HeyPCB/iris-brow/media/top.png

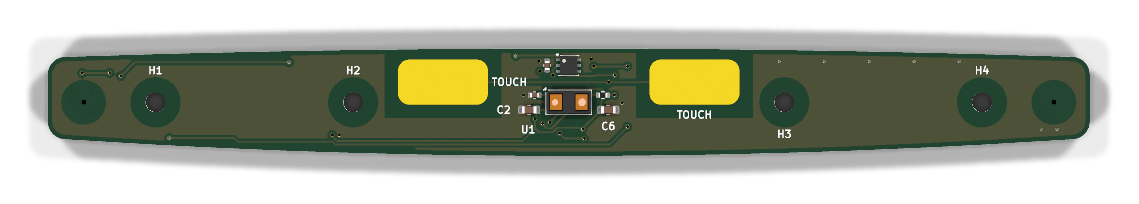
media/top.png
