HeyPCB/iris-brow/fab/iris_brow_bom.csv

Reference | Value | Footprint | MPN | LCSC | Qty
C1,C4,C5 | 100nF | Capacitor_SMD:C_0402_1005Metric | CL05B104KO5NNNC | C1525 | 3
C2 | 4.7uF | Capacitor_SMD:C_0603_1608Metric | CL10A475KO8NNNC | C19666 | 1
C3 | 1uF | Capacitor_SMD:C_0402_1005Metric | CL05A105KA5NQNC | C52923 | 1
C6 | 10uF | Capacitor_SMD:C_0603_1608Metric | CL10A106MA8NRNC | C96446 | 1
J1 | BROW (Cortex J4) | Connector_JST:JST_SH_SM08B-SRSS-TB_1x08-1MP_P1.00mm_Horizontal | SM08B-SRSS-TB(LF)(SN) | C160407 | 1
MK1,MK2 | ICS-43434 | Sensor_Audio:InvenSense_ICS-43434-6_3.5x2.65mm | ICS-43434 | C5656610 | 2
R1 | 10k | Resistor_SMD:R_0402_1005Metric | 0402WGF1002TCE | C25744 | 1
R2,R3 | 33 | Resistor_SMD:R_0402_1005Metric | 0402WGF330JTCE | C25105 | 2
U1 | VL53L1X | Sensor_Distance:ST_VL53L1x | VL53L1CXV0FY/1 | C190004 | 1
U2 | APDS-9306-065 | OptoDevice:Broadcom_DFN-6_2x2mm_P0.65mm | APDS-9306-065 | C2649498 | 1
