HeyPCB/iris-brow/fab/iris_brow.step

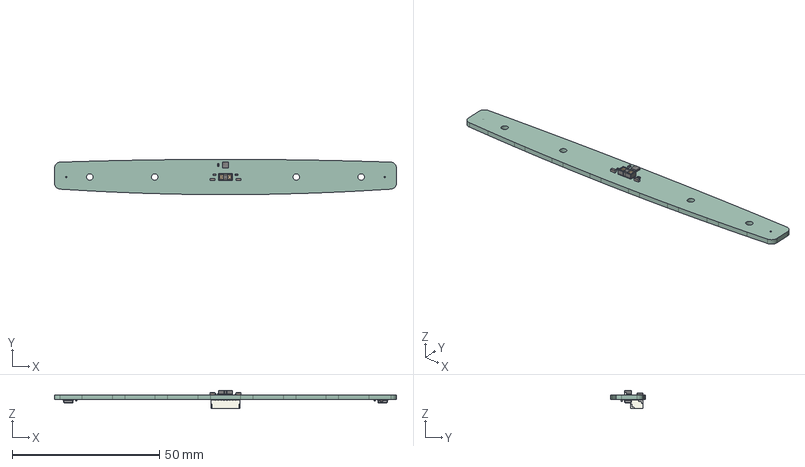
[picture p7: CAD file, 2026-10-03]
fab/iris_brow.step
116.0 x 12.0 x 6.20 mm
C_0402_1005Metric x 4
C_0603_1608Metric x 2
ST_VL53L1x
R_0402_1005Metric x 3
DFN-6-1EP_2x2mm_Pitch0.65mm
InvenSense_ICS-43434-6_3.5x2.65mm x 2
JST_SH_SM08B-SRSS-TB_1x08-1MP_P1.00mm_Horizontal
iris_brow_PCB
