HeyPCB/iris-brow/fab/iris_brow_schematic.pdf

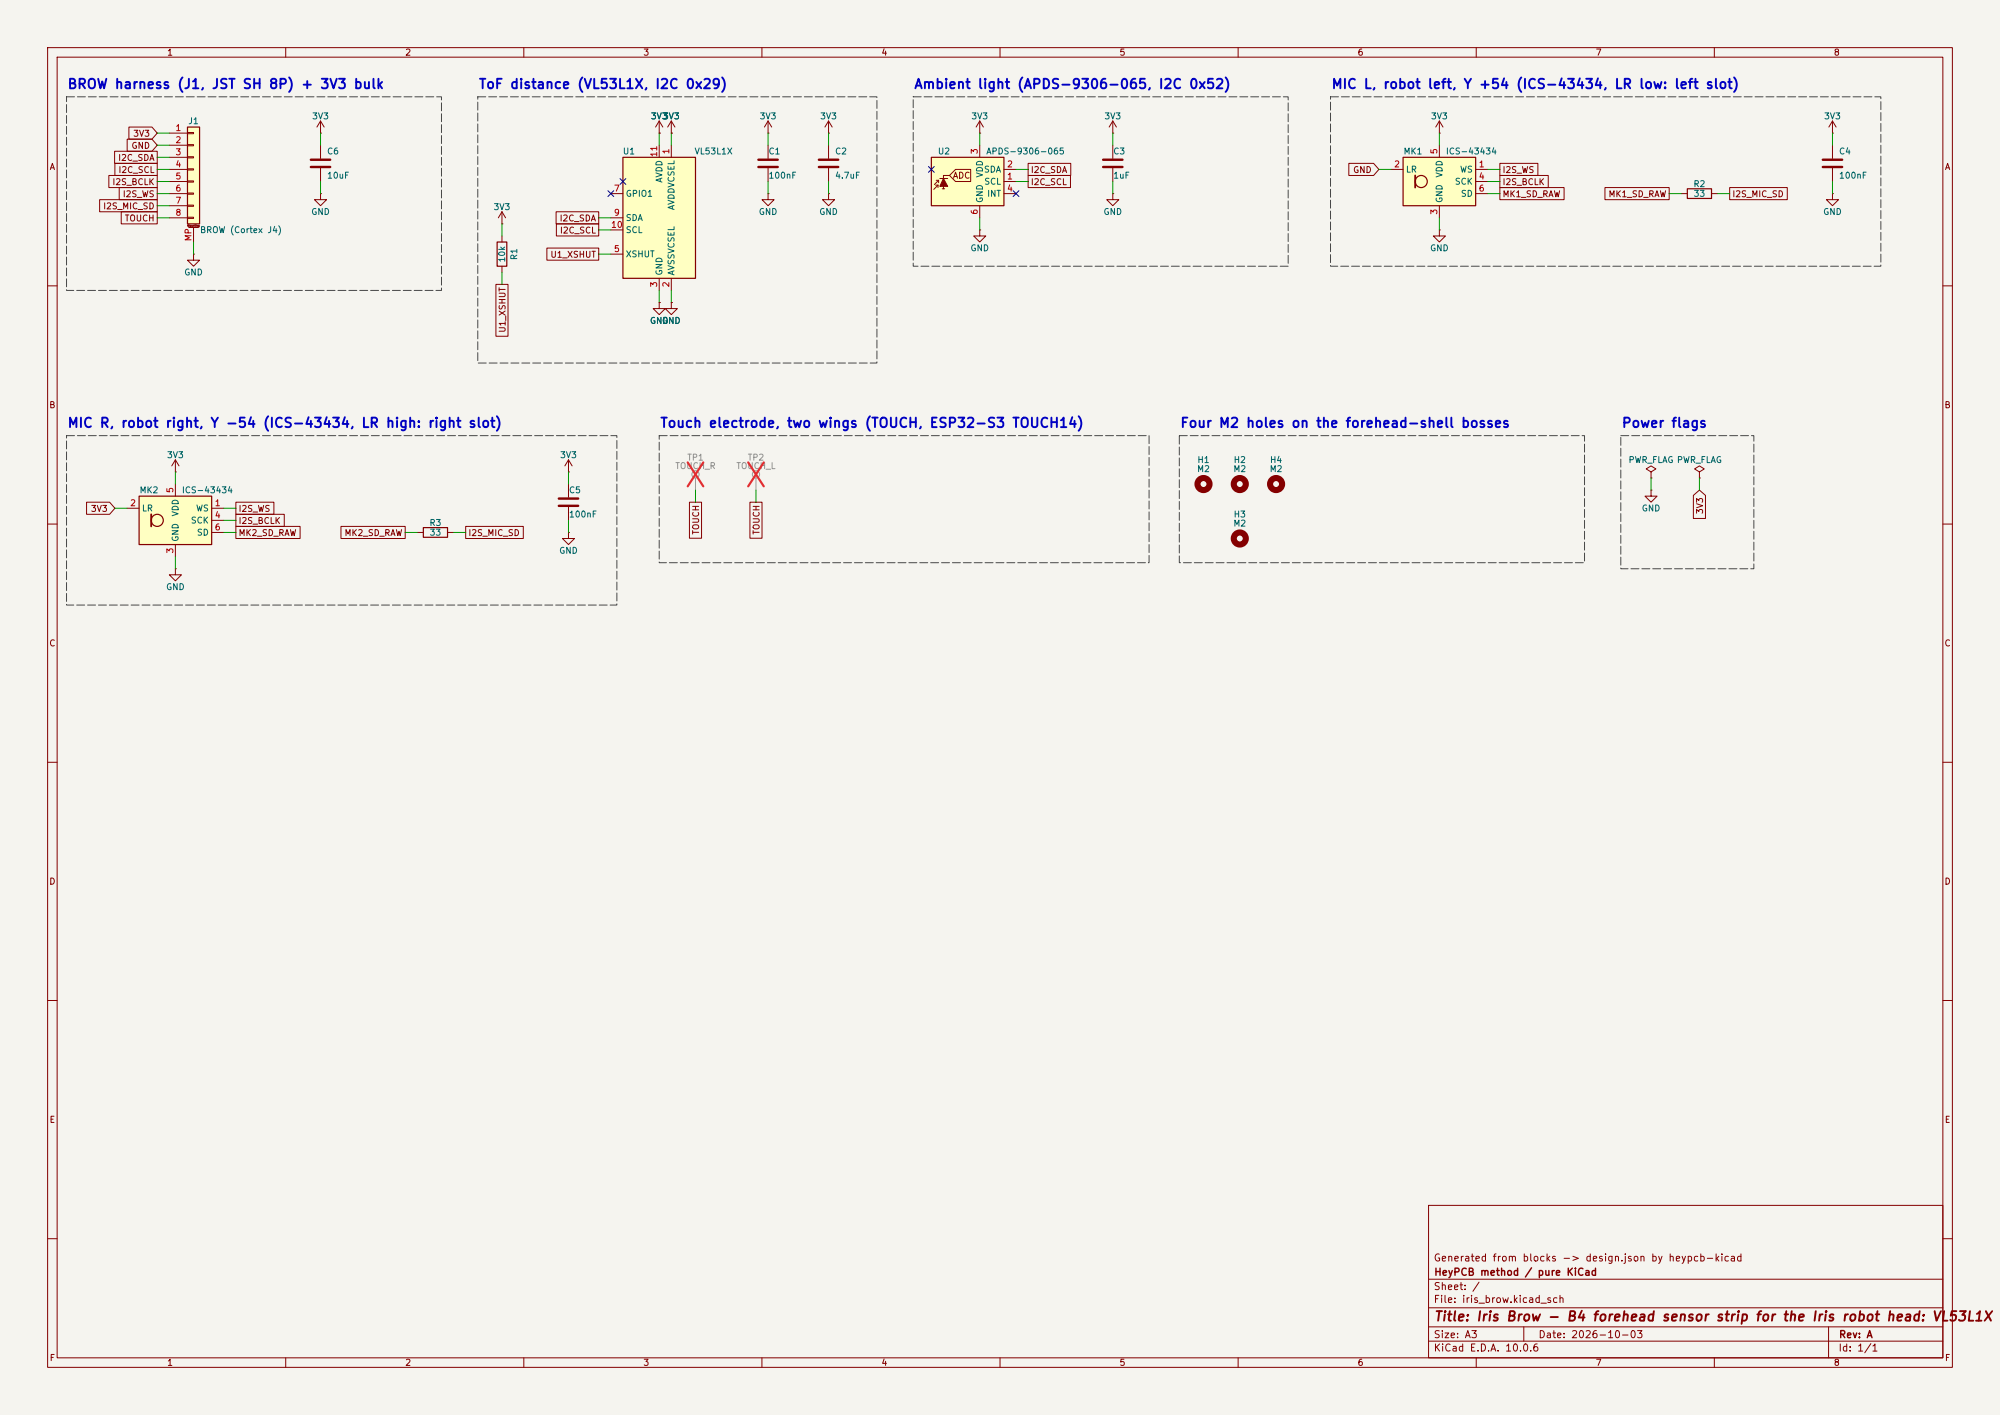
[picture p8: page 1]

BROW harness (J1, JST SH 8P) + 3V3 bulk

MIC L, robot left, Y +54 (ICS-43434, LR low: left slot)

Generated from blocks -> design.json by heypcb-kicad AVDDVCSEL 1 AVSSVCSEL 2 GND

Touch electrode, two wings (TOUCH, ESP32-S3 TOUCH14)

Four M2 holes on the forehead-shell bosses

HeyPCB method / pure KiCad
Sheet: /
File: iris_brow.kicad_sch
Title: Iris Brow - B4 forehead sensor strip for the Iris robot head: VL53L1X ToF, APDS-9306 light, two ICS-43434 I2S mics 108 mm apart, touch electrode

Size: A3 | Rev: A | F Date: 2026-10-03
KiCad E.D.A. 10.0.6 | Id: 1/1
