HeyPCB/iris-brow/kicad/iris_brow.kicad_pcb

## KiCad design kicad/iris_brow.kicad_pcb (2026-10-03)

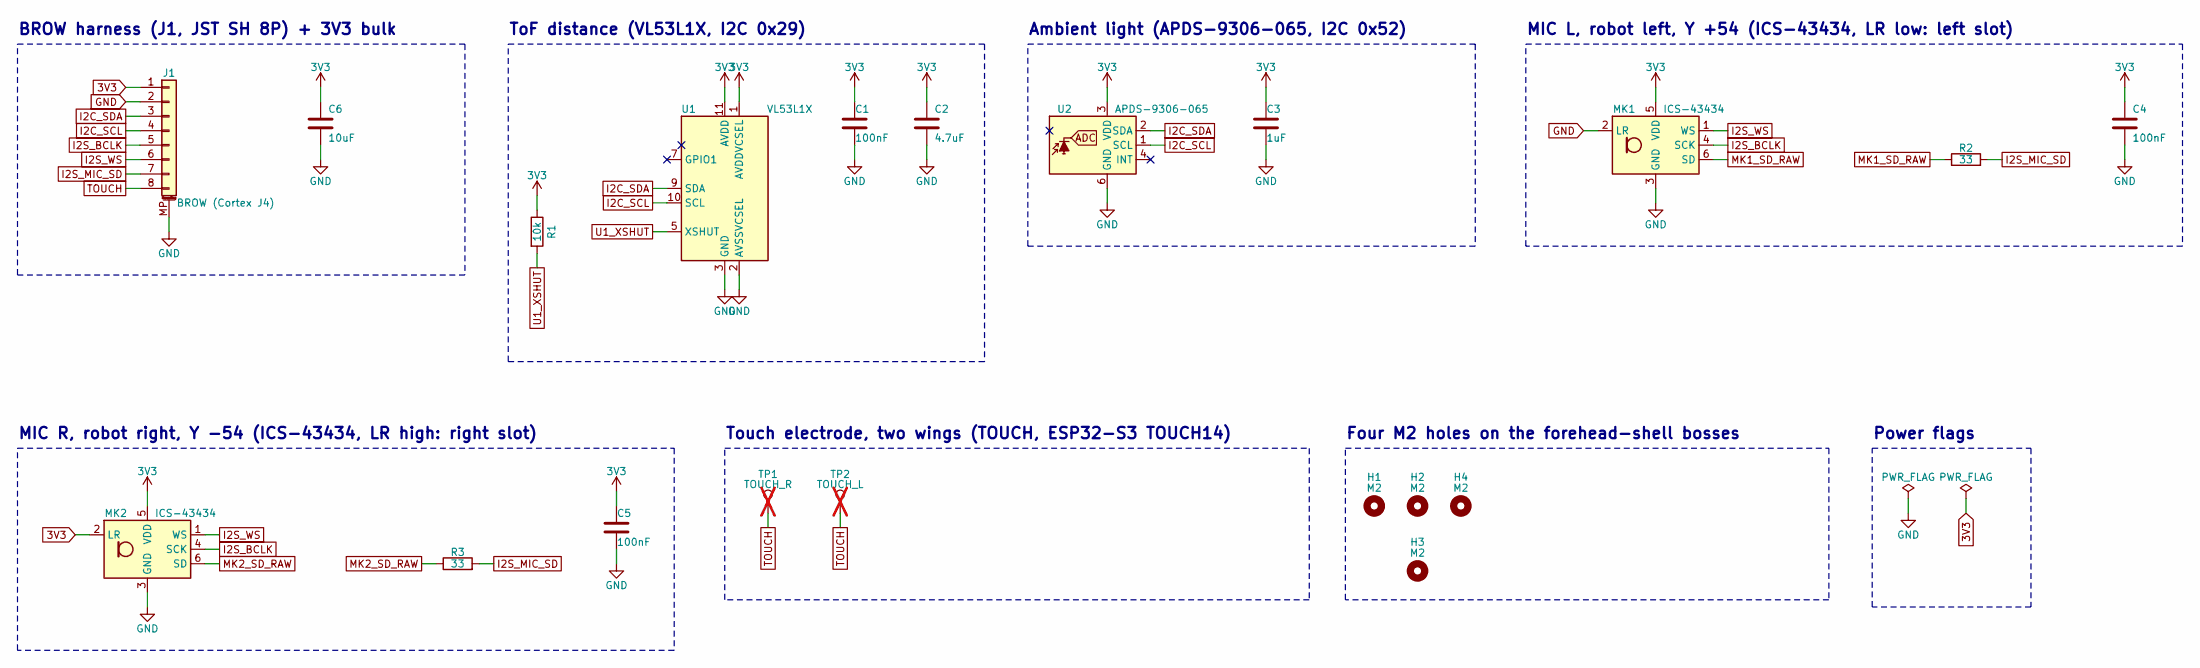
[picture p9: schematic iris_brow.kicad_sch, Iris Brow - B4 forehead sensor strip for the Iris robot hea…]

Parts:
C1, C4, C5: 100nF; C_0402_1005Metric; MPN CL05B104KO5NNNC; LCSC C1525
C2: 4.7uF; C_0603_1608Metric; MPN CL10A475KO8NNNC; LCSC C19666
C3: 1uF; C_0402_1005Metric; MPN CL05A105KA5NQNC; LCSC C52923
C6: 10uF; C_0603_1608Metric; MPN CL10A106MA8NRNC; LCSC C96446
H1, H2, H3, H4: M2; MountingHole_2.2mm_M2
J1: BROW (Cortex J4); JST_SH_SM08B-SRSS-TB_1x08-1MP_P1.00mm_Horizontal; MPN SM08B-SRSS-TB(LF)(SN); LCSC C160407
MK1, MK2: ICS-43434; InvenSense_ICS-43434-6_3.5x2.65mm; MPN ICS-43434; LCSC C5656610
R1: 10k; R_0402_1005Metric; MPN 0402WGF1002TCE; LCSC C25744
R2, R3: 33; R_0402_1005Metric; MPN 0402WGF330JTCE; LCSC C25105
TP1: TOUCH_R; SolderWirePad_1x01_SMD_5x10mm; not fitted
TP2: TOUCH_L; SolderWirePad_1x01_SMD_5x10mm; not fitted
U1: VL53L1X; ST_VL53L1x; MPN VL53L1CXV0FY/1; LCSC C190004
U2: APDS-9306-065; Broadcom_DFN-6_2x2mm_P0.65mm; MPN APDS-9306-065; LCSC C2649498

Connections:
3V3: C1.1, C2.1, C3.1, C4.1, C5.1, C6.1, J1.1, MK1.5 (VDD), MK2.2 (LR), MK2.5 (VDD), R1.1, U1.1 (AVDDVCSEL), U1.11 (AVDD), U2.3 (VDD)
GND: C1.2, C2.2, C3.2, C4.2, C5.2, C6.2, J1.2, J1.MP (MountPin), MK1.2 (LR), MK1.3 (GND), MK2.3 (GND), U1.2 (AVSSVCSEL), U1.3 (GND), U1.4 (GND), U1.6 (GND), U1.12 (GND), U2.6 (GND)
I2C_SCL: J1.4, U1.10 (SCL), U2.1 (SCL)
I2C_SDA: J1.3, U1.9 (SDA), U2.2 (SDA)
I2S_BCLK: J1.5, MK1.4 (SCK), MK2.4 (SCK)
I2S_MIC_SD: J1.7, R2.2, R3.2
I2S_WS: J1.6, MK1.1 (WS), MK2.1 (WS)
MK1_SD_RAW: MK1.6 (SD), R2.1
MK2_SD_RAW: MK2.6 (SD), R3.1
TOUCH: J1.8, TP1.1, TP2.1
U1_XSHUT: R1.2, U1.5 (XSHUT)

Notes on the sheet:
BROW harness (J1, JST SH 8P) + 3V3 bulk
ToF distance (VL53L1X, I2C 0x29)
Ambient light (APDS-9306-065, I2C 0x52)
MIC L, robot left, Y +54 (ICS-43434, LR low: left slot)
MIC R, robot right, Y -54 (ICS-43434, LR high: right slot)
Touch electrode, two wings (TOUCH, ESP32-S3 TOUCH14)
Four M2 holes on the forehead-shell bosses
Power flags

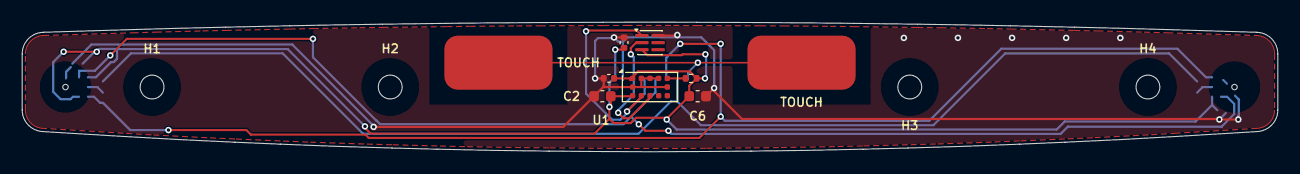
[picture p10: board iris_brow.kicad_pcb from above]

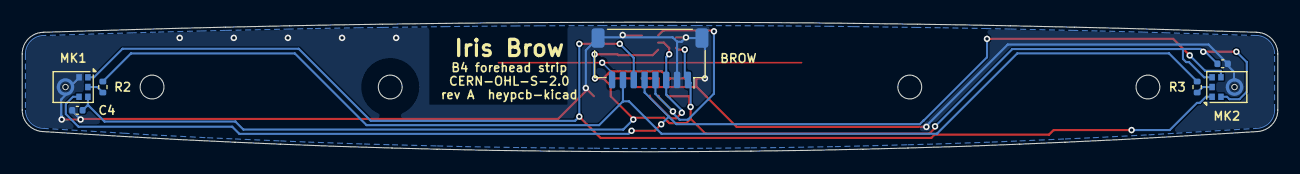
[picture p11: board iris_brow.kicad_pcb from below]

Board: 2 copper layers, 116.0 x 12.0 mm, 20 parts (7 on the bottom side), 11 nets.
